xjakubo/Autonomiczny_pojazd_polua/README.md

# Autonomiczny pojazd PolUa
Pojazd autonomiczny budowany w ramach współpracy Polsko-Ukraińskiej 2020
